ddribin/piano-lights-hw/README.md

# Piano Lights Hardware

Specialized hardware to displays lights (LEDs) over piano keys.

See a [demo video on YouTube](https://youtu.be/pe3vuLcroIA).
