ddribin/piano-lights-hw/faceplate/midi-out-faceplate.dxf

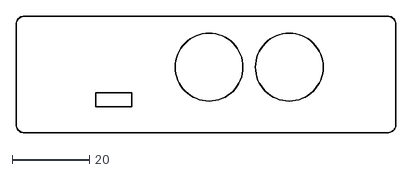
[picture p1: CAD file, 2023-07-03]
faceplate/midi-out-faceplate.dxf
98.0 x 30.0
