ddribin/piano-lights-hw/faceplate/midi-in-faceplate.dxf

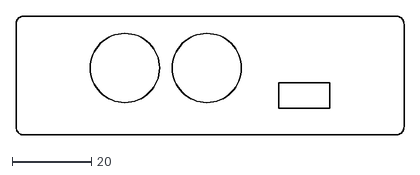
[picture p2: CAD file, 2023-07-03]
faceplate/midi-in-faceplate.dxf
98.0 x 30.0
