ddribin/piano-lights-hw/pcb/piano-lights.kicad_pcb

## KiCad design pcb/piano-lights.kicad_pcb (2023-08-04)

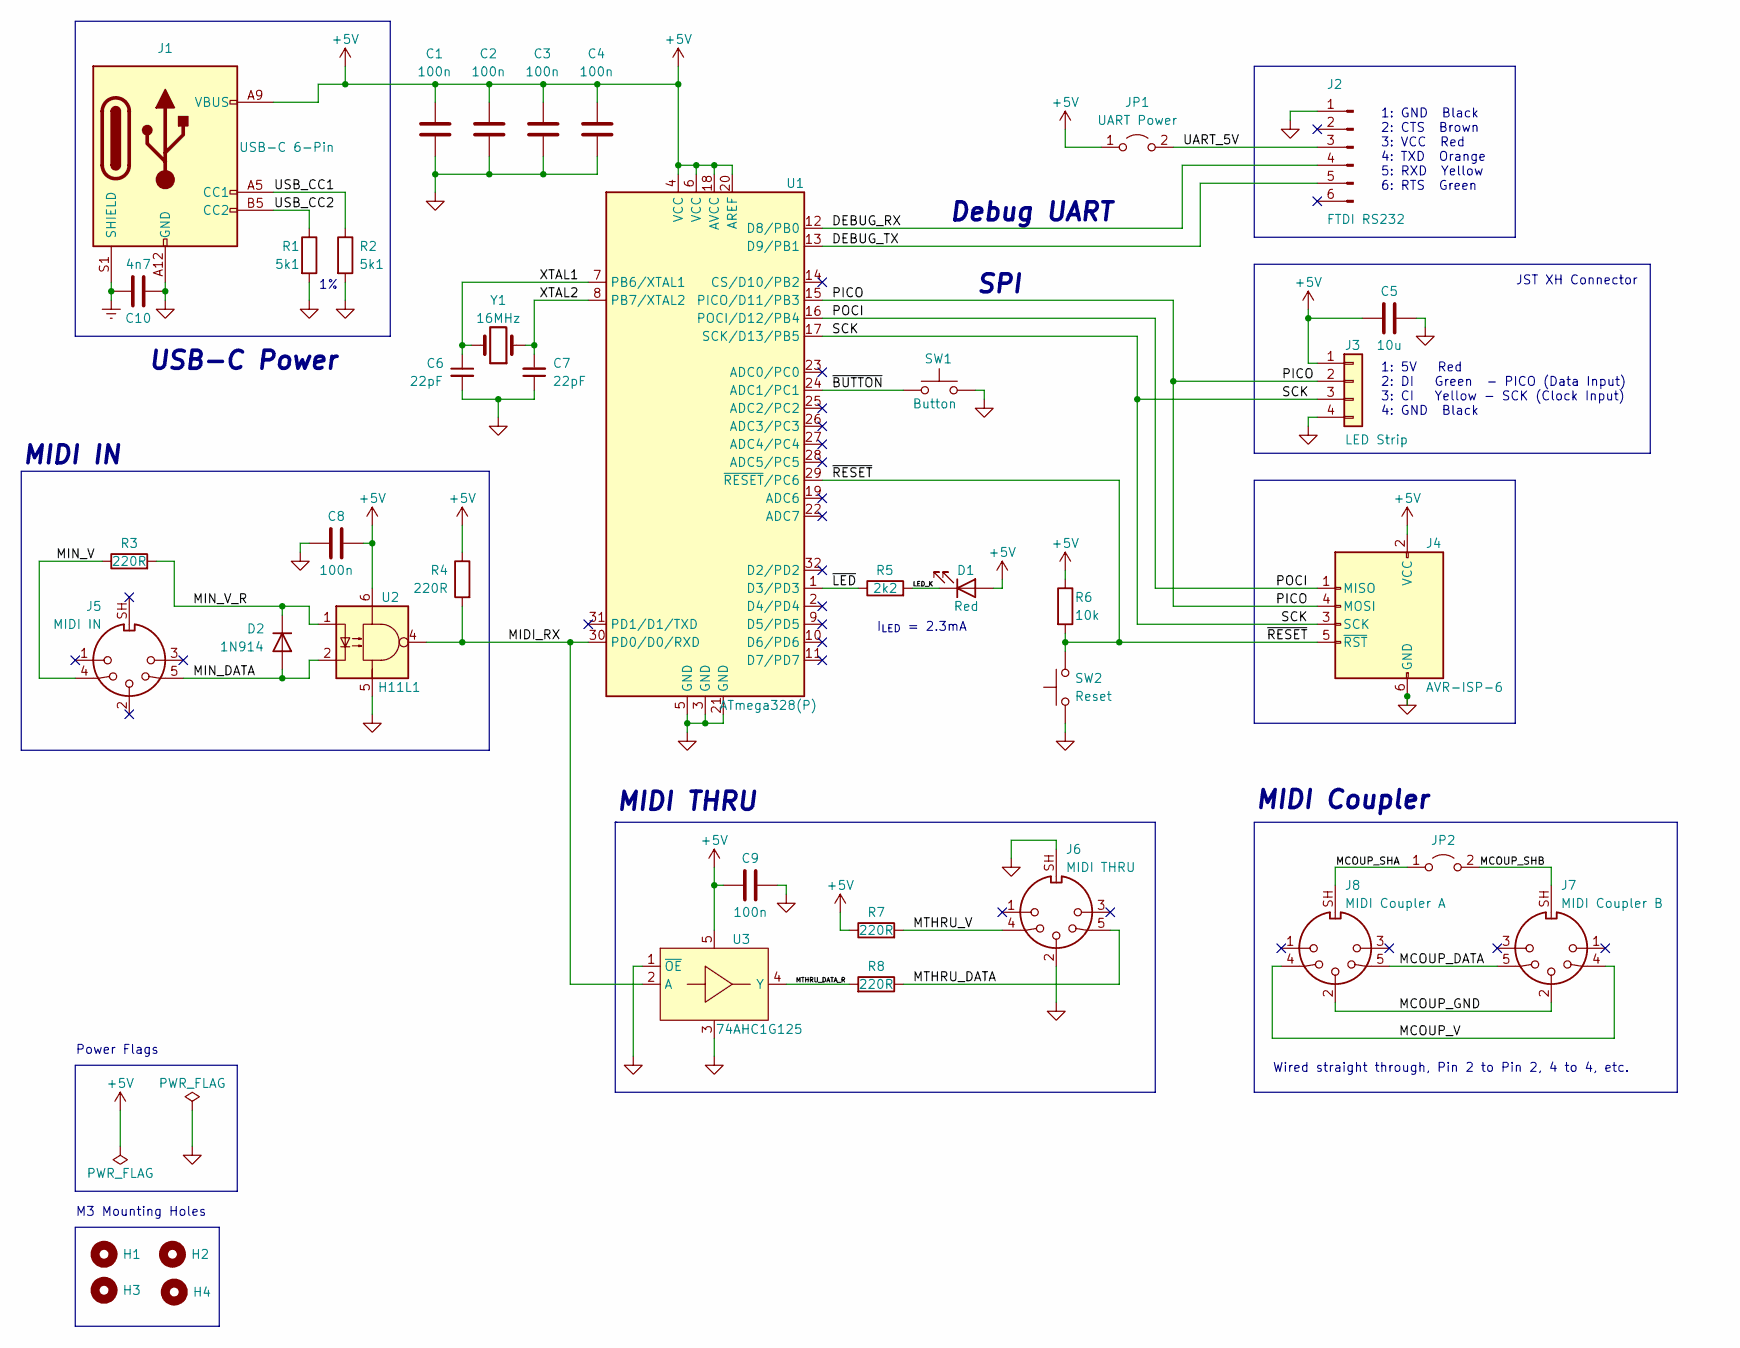
[picture p3: schematic piano-lights.kicad_sch, Piano Lights]

Parts:
C1, C2, C3, C4, C8, C9: 100n; C_0603_1608Metric_Pad1.08x0.95mm_HandSolder; Mfr Part GRM188R72A104KA35D
C5: 10u; CP_Radial_D5.0mm_P2.00mm; Mfr Part UVR1C100MDD
C6, C7: 22pF; C_0603_1608Metric_Pad1.08x0.95mm_HandSolder; Mfr Part GCM1885C2A220JA16D
C10: 4n7; C_0805_2012Metric_Pad1.18x1.45mm_HandSolder; Mfr Part GRM2165C1H472JA01D
D1: Red; LED_0603_1608Metric_Pad1.05x0.95mm_HandSolder; Mfr Part SML-D12U8WT86
D2: 1N914; D_SOD-123; Mfr Part MMSD4148T1G
H1, H2, H3, H4: MountingHole; MountingHole_3.2mm_M3
J1: USB-C 6-Pin; GCT_USB4125-GF-A-0190_REVA2; Mfr Part USB4125-GF-A-0190
J2: FTDI RS232; PinHeader_1x06_P2.54mm_Vertical
J3: LED Strip; JST_XH_S4B-XH-A_1x04_P2.50mm_Horizontal
J4: AVR-ISP-6; PinHeader_2x03_P2.54mm_Vertical; Mfr Part PR20203VBDN
J5: MIDI IN; CUI_SDS-50J; Mfr Part SDS-50J
J6: MIDI THRU; CUI_SDS-50J; Mfr Part SDS-50J
J7: MIDI Coupler B; CUI_SDS-50J; Mfr Part SDS-50J
J8: MIDI Coupler A; CUI_SDS-50J; Mfr Part SDS-50J
JP1: UART Power; PinHeader_1x02_P2.54mm_Vertical
JP2: MIDI Coupler Shield; PinHeader_1x02_P2.54mm_Vertical
R1, R2: 5k1; R_0603_1608Metric_Pad0.98x0.95mm_HandSolder; Mfr Part RC0603FR-075K1L
R3, R4, R7, R8: 220R; R_0603_1608Metric_Pad0.98x0.95mm_HandSolder; Mfr Part RC0603JR-07220RL
R5: 2k2; R_0603_1608Metric_Pad0.98x0.95mm_HandSolder; Mfr Part RC0603JR-072K2L
R6: 10k; R_0603_1608Metric_Pad0.98x0.95mm_HandSolder; Mfr Part RC0603JR-0710KL
SW1: Button; SW_PUSH_6mm_H5mm; Mfr Part CT11025.0F160
SW2: Reset; SW_PUSH_6mm_H5mm; Mfr Part CT11025.0F160
U1: ATmega328(P); TQFP-32_7x7mm_P0.8mm; Mfr Part ATMEGA328-AUR
U2: H11L1; SMDIP-6_W9.53mm; Mfr Part H11L1M
U3: 74AHC1G125; SOT-23-5_HandSoldering; Mfr Part 74AHC1G125GV,125
Y1: 16MHz; Crystal_HC49-U_Vertical; Mfr Part ECS-160-18-4X-CKM

Connections:
+5V: C1.1, C2.1, C3.1, C4.1, C5.1, C8.2, C9.1, D1.2 (A), J1.A9 (VBUS), J1.B9 (VBUS), J3.1, J4.2 (VCC), JP1.1 (A), R4.1, R6.1, R7.1, U1.4 (VCC), U1.6 (VCC), U1.18 (AVCC), U1.20 (AREF), U2.6, U3.5
/DEBUG_RX: J2.4, U1.12 (D8/PB0)
/DEBUG_TX: J2.5, U1.13 (D9/PB1)
/LED_K: D1.1 (K), R5.2
/MCOUP_DATA: J7.5, J8.5
/MCOUP_GND: J7.2, J8.2
/MCOUP_SHA: J8.SH, JP2.1 (A)
/MCOUP_SHB: J7.SH, JP2.2 (B)
/MCOUP_V: J7.4, J8.4
/MIDI_RX: R4.2, U1.30 (PD0/D0/RXD), U2.4, U3.2 (A)
/MIN_DATA: D2.2 (A), J5.5, U2.2
/MIN_V: J5.4, R3.1
/MIN_V_R: D2.1 (K), R3.2, U2.1
/MTHRU_DATA: J6.5, R8.1
/MTHRU_DATA_R: R8.2, U3.4 (Y)
/MTHRU_V: J6.4, R7.2
/PICO: J3.2, J4.4 (MOSI), U1.15 (PICO/D11/PB3)
/POCI: J4.1 (MISO), U1.16 (POCI/D12/PB4)
/SCK: J3.3, J4.3 (SCK), U1.17 (SCK/D13/PB5)
/UART_5V: J2.3, JP1.2 (B)
/USB_CC1: J1.A5 (CC1), R2.1
/USB_CC2: J1.B5 (CC2), R1.1
/XTAL1: C6.1, U1.7 (PB6/XTAL1), Y1.2
/XTAL2: C7.2, U1.8 (PB7/XTAL2), Y1.1
/~BUTTON: SW1.1, U1.24 (ADC1/PC1)
/~LED: R5.1, U1.1 (D3/PD3)
/~RESET: J4.5 (~RST), R6.2, SW2.2, U1.29 (~RESET/PC6)
Earth: C10.2, J1.S1 (SHIELD)
GND: C1.2, C2.2, C3.2, C4.2, C5.2, C6.2, C7.1, C8.1, C9.2, C10.1, J1.A12 (GND), J1.B12 (GND), J2.1, J3.4, J4.6 (GND), J6.2, J6.SH, R1.2, R2.2, SW1.2, SW2.1, U1.3 (GND), U1.5 (GND), U1.21 (GND), U2.5, U3.1 (~OE), U3.3

Notes on the sheet:
1: GND Black 2: CTS Brown 3: VCC Red 4: TXD Orange 5: RXD Yellow 6: RTS Green
MIDI THRU
Debug UART
1: 5V Red 2: DI Green - PICO (Data Input) 3: CI Yellow - SCK (Clock Input) 4: GND Black
Wired straight through, Pin 2 to Pin 2, 4 to 4, etc.
JST XH Connector
I_{LED} = 2.3mA
USB-C Power
MIDI IN
SPI
MIDI Coupler
Power Flags
M3 Mounting Holes

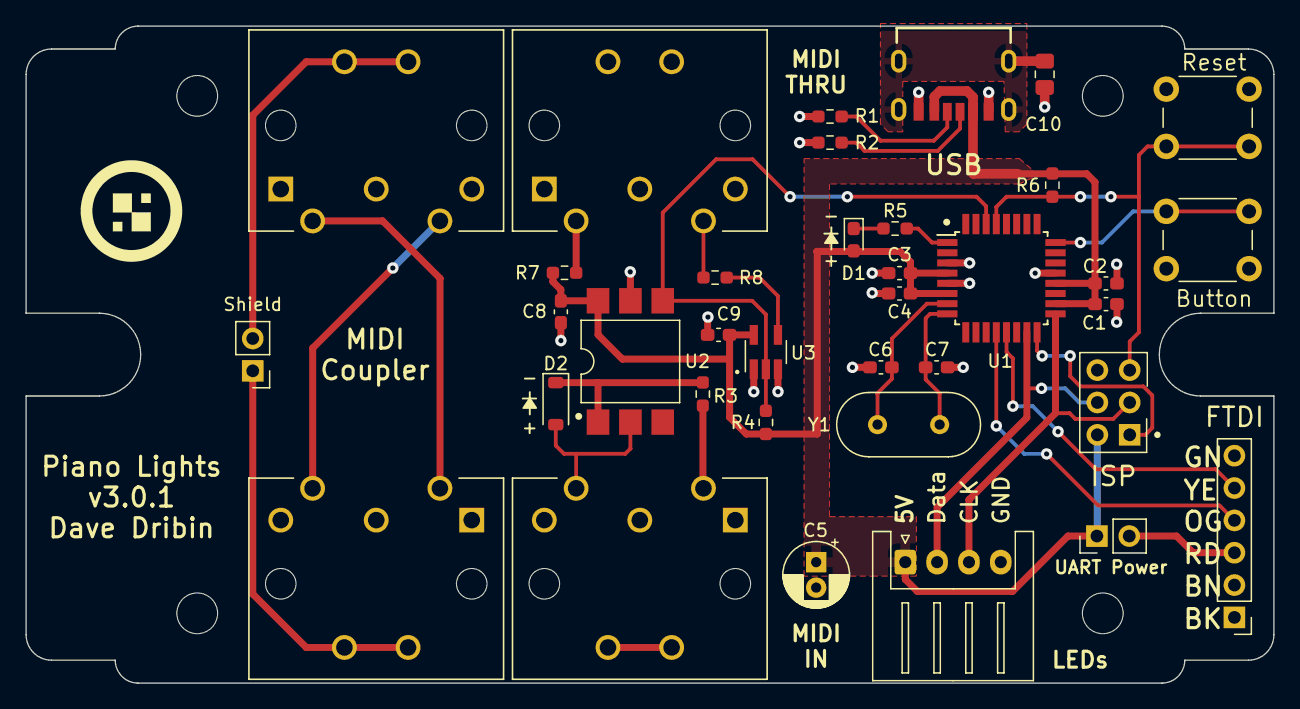
[picture p4: board piano-lights.kicad_pcb from above]

Board: 2 copper layers, 98.0 x 51.6 mm, 41 parts (0 on the bottom side), 29 nets.

Other parts of the board:
G1: LOGO
