ddribin/piano-lights-hw/(threads)

Thread 1 (2022-07-12):

Diode footprint is incorrect - should be MiniMELF not 0805

ddribin, 2022-07-12:
In `v1.0.0`, the footprint for Diode D2 (the reverse protection diode on MIDI IN) has a "0805" footprint when it should be "MiniMELF (SOD-80)" as that is much more common for SMD diodes.

ddribin, 2022-07-12:
Link to the Microchip 1N914UR at Digi-Key: https://www.digikey.com/en/products/detail/microchip-technology/1N914UR/4379567

ddribin, 2022-08-12:
Fixed in v1.0.1.

Closed 2022-08-12.

Thread 2 (2022-07-12):

Switch to SMD part for H11L1

ddribin, 2022-07-12:
The through-hole variant of the H11L1 optocoupler is mostly out of stock and hard to find. Switch to the surface mount part and footprint, as that is currently still readily available (as of July 2022, at least).

ddribin, 2022-07-16:
Opened against `v1.0.0`.

Closed 2023-03-06.

Thread 3 (2022-07-16):

Inputs to H11L1 optocoupler are reversed

ddribin, 2022-07-16:
The inputs to H11L1 optocoupler are reversed. `MIDI IN Data` is going into the anode and `MIDI IN Vcc` is going to cathode. This is incorrect. `Data` should go to the cathode and `Vcc` should go to the anode.

Incorrect schematic as of `v1.0.0`:

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

Correct schematic from the MIDI standard:

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

I think what threw me is the picture of internal diode for the H11L1 is reversed from the MIDI standard.

ddribin, 2022-08-12:
Fixed in v1.0.1.

Closed 2022-08-12.

Thread 4 (2022-07-16):

MIDI IN output from the optocoupler is missing a pull-up resistor

ddribin, 2022-07-16:
The MIDI IN output from the optocoupler is missing a pull-up resistor. Here's the schematic as of `v1.0.0`:

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

And here is the MID standard:

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

The pull-up resistor, `Rd` is missing.

ddribin, 2022-08-12:
Fixed in v1.0.1.

Closed 2022-08-12.

Thread 5 (2022-08-08):

No solder mask between USB connector pads

ddribin, 2022-08-08:
In `v1.0.0`, the solder mask constraints did not allow solder mask between the USB connector pads. See the attached screenshot. This made it difficult to solder the pads as it was hard to avoid solder bridges between the pads. This is not super critical, as none of the data pins are connected with a USB changer, but bridges should be avoided in case the data lines are actually connected.

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

ddribin, 2022-08-12:
This happened because the "Board Stickup > Solder Mask/Paste > Solder mask minimum web width" was set to 0.2mm, as seen in the screen shot. The the copper for the pads is 0.2mm apart, but the solder mask goes over by 0.05mm leaving a 0.1mm gap between the solder mask, which is below this "web width".  Setting it to 0.1mm or lower (e.g. 0.05mm) allows solder mask between between the pads.

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

ddribin, 2022-08-12:
Fixed in v1.0.1.

ddribin, 2022-08-12:
Fixed it looks like this:

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

Closed 2022-08-12.

Thread 10 (2023-03-06):

Change FTDI +5V trace to a normal power trace, instead of copper pour

ddribin, 2023-03-06:
Change FTDI power to a normal trace, instead of copper pour. The pour is unnecessary as FTDI cannot supply that much current, anyways. Even when using a serial port, it will most likely still be powered by the USB-C port.

Closed 2023-03-06.

Thread 7 (2023-03-06):

Switch LED to 0603 package

ddribin, 2023-03-06:
In `v2.0.0`, the LED is an `0805`. Switch to `0603`, maybe?

ddribin, 2023-03-06:
This does not save that much space, but possible replacement is Rohm SML-D12U8WT86: https://www.digikey.com/short/h5q7qdm2

ddribin, 2023-03-13:
Changed it for consistency.

Closed 2023-03-13.

Thread 8 (2023-03-06):

Switch LED strip to some sort of connector

ddribin, 2023-03-06:
Soldering the LED strip wires directly to the board is kind of a pain. Also, there's a pigtail hanging off, that's annoying. It would be really nice to use some soft of wire-to-board connector instead of wires directl.

ddribin, 2023-03-06:
The current connector is a JST-SM connector, which has no wire-to-board option. Here's a list of common JST connectors:

https://www.mattmillman.com/info/crimpconnectors/common-jst-connector-types/

The JST PH or XH look like good options. The PH only supports 2A with AWG 24-28 wire, while XH is 3A with AWG 22-28 wire. Both support right-angle through-hole headers. I am thinking XH is good, due to the bigger wires, but need to do some test crimps.

ddribin, 2023-03-06:
JST PH housing, 4 position is `PHR-4`: https://www.arrow.com/en/products/phr-4/jst-manufacturing
Contact AWG 24-30 is `SPH-002T-P0.5S`: https://www.arrow.com/en/products/sph-002t-p0.5s/jst-manufacturing

JST XH housing, 4 position is `XHP-4`: https://www.arrow.com/en/products/xhp-4/jst-manufacturing
Contact AWG 22-28 is `SXH-001T-P0.6`:  https://www.arrow.com/en/products/sxh-001t-p0.6/jst-manufacturing

ddribin, 2023-03-13:
`S4B-XH-A` looks like a good fit. While `S4B-XH-A-1` has a smaller profile, it doesn't help board layout, and in fact makes the power pour more difficult, so stick with `S4B-XH-A`.

Closed 2023-03-13.

Thread 9 (2023-03-06):

Switch to SMD push buttons

ddribin, 2023-03-06:
Switch to SMD push buttons instead of through hole.

ddribin, 2023-03-06:
Possible replacement: C&K PTS645SH43SMTR92 LFS: https://www.digikey.com/short/v84t9hpm

ddribin, 2023-03-06:
The SMD footprints are actually larger than the through-hole. Plus vias are still needed to ground Not sure how much benefit there is to this?

ddribin, 2023-03-06:
Footprint would be `SW_Push_1P1T_NO_6x6mm_H9.5mm`

ddribin, 2023-03-13:
These take up more room on the PCB making things harder to layout.

Thread 11 (2023-03-07):

Switch crystal to SMD

ddribin, 2023-03-07:
Switch the crystal to SMD. Current part is ECS `ECS-160-18-4X-CKM`, 16MHz 18pF load capacitance, through hole HC-49USX.

ddribin, 2023-03-07:
Alternative looks to be ECS `ECS-160-18-5PXEN-TR`: https://www.digikey.com/short/790zwv4t

ddribin, 2023-03-13:
This ends up taking more room on the PCB making things harder to layout.

Thread 12 (2023-07-01):

Isolate USB-C shield from ground

ddribin, 2023-07-01:
There doesn't seem to be a good consensus here, but the USB-C shield should maybe be isolated from signal ground.

Some references:

# Microchip: USB Type-C Layout Recommendations

Shield is connected to ground through an RC filter with unspecified R and C.

https://microchip.my.site.com/s/article/USB-Type-C-Layout-Recommendations

> There should be a wide Earth Ground flood around the USB Type-C connector that connects to the connector shield pins. Earth Ground should also be tied to Digital Ground through an R/C galvanic circuit that is placed as close as possible to the USB Type-C connector (see R20 and C2 in Figure 1).

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

# Atmel AVR1017: USB Hardware Design Recommendations

Shield is connected to ground through an RC filter with R=1M and C=4n7.

https://ww1.microchip.com/downloads/en/Appnotes/doc8388.pdf

> Tying the shield directly to ground would create a direct path from the ground plane to the shield, turning the USB cable into an antenna. To limit the USB cable antenna effect, it is recommended to connect the shield and ground through an RC filter. Typically, R = 1MΩ and C = 4.7nF in Figure 3-5.

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

# PCBWay: How to add USB-C to your projects

Shield is connected to ground through a 1M resistor.

https://www.pcbway.com/blog/PCB_Design_Tutorial/How_to_add_USB_C_to_your_projects.html

> However, compared to the micro USB-B two resistors are needed on pins CC1 and CC2. Then just add a 1M resistor to the connector shield. Also, you just connect the following lines (Vbus, D +, D-, GND) as you usually do with the micro USB-B. You can leave all other pins unconnected.

# Arduino Forums: Should I connect Micro USB B shield to the ground?

Shield is unconnected. Should only be connected on the computer end. Thus unconnected on a device.

https://forum.arduino.cc/t/should-i-connect-micro-usb-b-shield-to-the-ground/960018/3

# SparkFun: USB-C Breakout

Shield is unconnected.

https://www.sparkfun.com/products/15100
https://github.com/sparkfun/USB-C-Breakout
https://forum.digikey.com/t/simple-way-to-use-usb-type-c-to-get-5v-at-up-to-3a-15w/7016

# Adafruit: USB-C Breakpoint

Shield is unconnected.

https://www.adafruit.com/product/4090
https://github.com/adafruit/Adafruit-USB-C-Downstream-Breakout

# Phil's Lab: USB-C Power Delivery

Shield is unconnected.

https://youtu.be/W13HNsoHj7A?t=724

# Phil's Lab: USB Hub Design

Shield is connected to ground through 4n7F capacitor.

https://youtu.be/iR2hYpq0KI0?t=576

# Phil's Lab: USB Headphone Amplifier

Shield connected to ground through an RC filter with R=DNP and C=2n2F.

https://youtu.be/-L-fKuAbQ9s?t=527

# Dubious Creations: ESP32 LED Driver

Shield is connected directly to ground.

https://dubiouscreations.com/2021/05/04/designing-an-esp32-based-rgb-matrix-driver-and-making-500-of-them/
https://github.com/matthewlai/ESP32LEDControl
https://dubiouscreations.com/2021/04/06/designing-with-usb-c-lessons-learned/

ddribin, 2023-07-01:
In summary, all possible permutations are "recommended":

- Connect shield to ground through an RC filter, with R = 1M and C = 4.7nF.
- Connect shield to ground through only a 1M resistor.
- Connect shield to ground through only a 4n7F.
- Connect shield directly to ground.
- Leave shield unconnected.

My guess is that the RC filter is the most robust, but also is the most difficult to layout.

I think I'm going to take a middle road, and add a single 0803 connection from shield (Earth) to ground (GND). Then it can handle every case, except the RC filter:

- Leave it unpopulated.
- Use a 0R resistor.
- Use a 1M resistor
- Use a 4n7F capacitor.

Closed 2023-07-04.

Thread 13 (2023-07-28):

Silkscreen for LED D1 is reversed

ddribin, 2023-07-28:
The silkscreen for LED D1 is reversed on the PCB in `v3.0.0`:

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

The `+` sign should be on the `+5` wire.

Closed 2023-07-28.
