ddribin/piano-lights-hw/(commit log)

2022-06-04 Flesh out circuit
    [piano-lights.kicad_sch]
2022-06-04 Add debug port and more net labels
    [piano-lights.kicad_sch]
2022-06-08 Restructure the schematic and start adding footprints
    [piano-lights.kicad_sch]
2022-06-09 Finish footprints. Start laying out PCB.
    [piano-lights.kicad_pcb, piano-lights.kicad_sch]
2022-06-09 More PCB updates
    [piano-lights.kicad_pcb]
2022-06-10 Start the board layout
    [piano-lights.kicad_pcb, piano-lights.kicad_sch]
2022-06-18 PCB updates
    [piano-lights.kicad_pcb]
2022-06-19 Start re-working schematic (again)
    [piano-lights.kicad_sch]
2022-06-19 Finish reworking schematic
    [piano-lights.kicad_sch]
2022-06-19 Renumber components, and start over on the PCB.
    [piano-lights.kicad_pcb, piano-lights.kicad_sch]
2022-06-19 Update 74AHC1G125 symbol so that VCC and GND are at the top and bottom, respectively
    [piano-lights.kicad_sch]
2022-06-19 Minor schematic and PCB updates
    [piano-lights.kicad_pcb, piano-lights.kicad_sch]
2022-06-19 Move reset switch
    [piano-lights.kicad_sch]
2022-06-19 Move LED to D7/PD7
    [piano-lights.kicad_sch]
2022-06-19 Fix misaligned POCI wire
    [piano-lights.kicad_sch]
2022-06-19 Add in a switch on D2/PD2. Move MIDI_RX to the left side.
    [piano-lights.kicad_sch]
2022-06-19 Clean up MIDI IN and THRU. Rename shield pin on the DIN5 connector to match the conventions.
    [piano-lights.kicad_sch]
2022-06-20 Add some 3D models and start laying out PCB (it's too small, though)
    [piano-lights.kicad_pcb, piano-lights.kicad_sch]
2022-06-21 Start laying out PCB
    [piano-lights.kicad_pcb, piano-lights.kicad_sch]
2022-06-22 Tweeak dimensions. Move LED connector to other side, closer to USB power.
    [piano-lights.kicad_pcb]
2022-06-22 Fully route board. Does not pass DRC, yet.
    [piano-lights.kicad_pcb]
2022-06-22 Fix up copper pours power puddles on the front
    [piano-lights.kicad_pcb]
2022-06-22 PCB tweaks
    [piano-lights.kicad_pcb]
2022-06-25 Fix up silk screen. Fix all DRC errors. Tweak position of LED holes.
    [piano-lights.kicad_pcb]
2022-06-26 Add a cutout in the side.
    [piano-lights.kicad_pcb]
2022-06-26 Add some more silk screen info
    [piano-lights.kicad_pcb]
2022-06-26 Minor trace tweaks. Move origin to center.
    [piano-lights.kicad_pcb]
2022-06-26 Clean up somem more tracks and passive placement
    [piano-lights.kicad_pcb]
2022-06-26 Update version text and date.
    [piano-lights.kicad_pcb, piano-lights.kicad_sch]
2022-06-26 Add a jumper for 5V UART power. Add more silk.
    [piano-lights.kicad_pcb, piano-lights.kicad_sch]
2022-06-26 Final tweaks
    [piano-lights.kicad_pcb]
2022-06-27 Tweak silkscreen
    [piano-lights.kicad_pcb]
2022-06-27 Make the hole wider
    [piano-lights.kicad_pcb]
2022-06-30 Last minue DRC updates for JLCPCB
    [piano-lights.kicad_pcb, piano-lights.kicad_sch]
2022-06-30 Update solder mask DRC
    [piano-lights.kicad_pcb]
2022-07-17 Mock up fixes for reversed H11L1 inputs and pull-up
    [piano-lights.kicad_pcb, piano-lights.kicad_sch]
2022-07-18 Clean up schematic mainly around MIDI IN
    [piano-lights.kicad_pcb, piano-lights.kicad_sch]
2022-07-18 Switch MIDI IN diode footprint to MiniMELF
    - Add some more silkscreen around AVR ISP-6 header.
    - Add silscreen text for USB Power.
    [piano-lights.kicad_pcb, piano-lights.kicad_sch]
2022-07-18 Fix DRC issues
    [piano-lights.kicad_pcb]
2022-07-18 Minor reroutes around MIDI IN
    [piano-lights.kicad_pcb]
2022-07-22 Silkscreen updates
    [piano-lights.kicad_pcb]
2022-08-07 Minor re-routing
    [piano-lights.kicad_pcb]
2022-08-07 Add some test points
    [piano-lights.kicad_pcb, piano-lights.kicad_sch]
2022-08-07 Update plot settings for JLCPCB
    [piano-lights.kicad_pcb]
2022-08-08 Update solder mask constraints to allow solder mask between USB connector pads
    - Update some JLCPCB constraints.
    - Update front copper pours to be right angles.
    [piano-lights.kicad_pcb]
2022-08-08 Move gerbers/ ignore to pcb/.gitignore
2022-08-12 Put component values on silkscreen
    [piano-lights.kicad_pcb]
2022-08-12 More silkscreen updates
    [piano-lights.kicad_pcb, piano-lights.kicad_sch]
2022-08-12 Update dates
    [piano-lights.kicad_pcb, piano-lights.kicad_sch]
2023-02-09 First pass at smaller PCB with MIDI coupler
    [piano-lights.kicad_pcb, piano-lights.kicad_sch]
2023-02-09 Fix up schematic, update to SMD CPU, and start laying out board
    [piano-lights.kicad_pcb, piano-lights.kicad_sch]
2023-02-10 More PCB routing
    [piano-lights.kicad_pcb, piano-lights.kicad_sch]
2023-02-10 Finish first pass of routing: no more unrouted nets. It fits!
    [piano-lights.kicad_pcb]
2023-02-11 Cleanup MIDI coupler wiring a bit
    [piano-lights.kicad_pcb]
2023-02-11 More routing updates
    [piano-lights.kicad_pcb]
2023-02-13 Update track widths
    [piano-lights.kicad_pcb]
2023-02-13 Add the button back, but on a different pin. Start cleaning up silkscreen
    [piano-lights.kicad_pcb, piano-lights.kicad_sch]
2023-02-13 Finish cleaning up silkscreen. Passes DRC. Add dimensions.
    [piano-lights.kicad_pcb]
2023-02-13 Last silkscreen tweaks
    [piano-lights.kicad_pcb]
2023-02-13 Reroute /LED signal away from the crystal
    [piano-lights.kicad_pcb]
2023-02-13 Move /LED to Pin 1 for easier PCB routing
    [piano-lights.kicad_pcb, piano-lights.kicad_sch]
2023-02-13 Update silkscreen for LED strip
    [piano-lights.kicad_pcb]
2023-02-13 Add silkscreen for all RS323/FTDI pins
    [piano-lights.kicad_pcb]
2023-02-13 More siklscreen tweaks
    [piano-lights.kicad_pcb]
2023-02-13 Simplify power distribution a bit
    [piano-lights.kicad_pcb]
2023-02-16 Start adding mfr, part, and vendor to schematic
    [piano-lights.kicad_sch]
2023-02-16 Add more Mfr notes
    [piano-lights.kicad_sch]
2023-02-16 Add more Mfr comments. Switch to SMD 0805 LED
    [piano-lights.kicad_pcb, piano-lights.kicad_sch]
2023-02-16 Update footprint of USB connector
    [piano-lights.kicad_pcb]
2023-02-16 Add logo on PCB silkscreen
    [piano-lights.kicad_pcb]
2023-02-16 Update revision and date
    [piano-lights.kicad_pcb, piano-lights.kicad_sch]
2023-02-18 Add USB-C Power only connector footprint for GCT USB4125-GF-A-0190.
2023-02-18 Switch to USB-C 6-Pin for power on the schematic
    [piano-lights.kicad_sch]
2023-02-18 Start wiring up USB-C connector
    [piano-lights.kicad_pcb, piano-lights.kicad_sch]
2023-02-18 Route out +5V to the LEDs with a copper pour
    [piano-lights.kicad_pcb]
2023-02-18 Widden +5V copper pour to 2mm
    [piano-lights.kicad_pcb]
2023-02-18 Increase Power net class width to 0.55mm
    [piano-lights.kicad_pcb]
2023-02-18 Make via sizes larger at 0.4mm drill and 0.9mm diameter. Fix resulting DRC errors.
    [piano-lights.kicad_pcb]
2023-02-18 Make longer pads on USB-C connector
    [piano-lights.kicad_pcb]
2023-02-18 Remove some extra silkscreen
    [piano-lights.kicad_pcb]
2023-02-18 Tweak hole clearances
    [piano-lights.kicad_pcb]
2023-02-18 Fix DRC errors and pull back the soldermask expansion to 0.0508
    [piano-lights.kicad_pcb]
2023-02-18 Move USB-C connector over to the left a bit to make room for a resistor on the right
    [piano-lights.kicad_pcb]
2023-02-18 Make FTDI power trace thicker (1.6mm)
    [piano-lights.kicad_pcb]
2023-02-18 Align some schematic components to 0.050in grid
    [piano-lights.kicad_sch]
2023-02-18 Minre schematic tweaks
    [piano-lights.kicad_sch]
2023-02-18 Swap J1 and J2 designators so J1 is at the upper left
    [piano-lights.kicad_pcb, piano-lights.kicad_sch]
2023-02-18 Minor PCB tweaks
    [piano-lights.kicad_pcb]
2023-02-18 Use copper pour instead of thick traces, to get thermal reliefs around through holes
    [piano-lights.kicad_pcb]
2023-02-19 Set Mfr, Mfr Part, and Vendor on most other components
    [piano-lights.kicad_sch]
2023-02-19 Clean up MIDI coupler schematic a bit
    [piano-lights.kicad_sch]
2023-02-19 Clean up ERC and DRC issues
    [piano-lights.kicad_pcb, piano-lights.kicad_sch]
2023-02-19 Simplify MIDI coupler by mirroring the second connector horizontally
    [piano-lights.kicad_sch]
2023-02-19 More schematic cleanups
    [piano-lights.kicad_sch]
2023-02-19 Move R8 a bit away from the copper pour
    [piano-lights.kicad_pcb]
2023-02-19 Move U3 a bit away from the copper pour
    [piano-lights.kicad_pcb]
2023-02-19 Make LED data and clock thicker traces
    [piano-lights.kicad_pcb]
2023-02-19 Increase padding around KiBuzzard labels to 5mm
    [piano-lights.kicad_pcb]
2023-02-19 Tigthen up ground pour around board outline
    [piano-lights.kicad_pcb]
2023-02-19 Cleanup SCK track a bit
    [piano-lights.kicad_pcb]
2023-02-19 Fill in part data for crystal
    [piano-lights.kicad_sch]
2023-02-19 Rearrange R7 and C8
    [piano-lights.kicad_pcb]
2023-02-19 Move C9 closer to U3. Fix DRC errors.
    [piano-lights.kicad_pcb]
2023-02-20 Minor tweaks
    [piano-lights.kicad_pcb, piano-lights.kicad_sch]
2023-02-20 Fill out Mfr fields for last capacitor in the schematic
    [piano-lights.kicad_sch]
2023-02-21 Add a jumper on the coupler shield
    [piano-lights.kicad_pcb, piano-lights.kicad_sch]
2023-02-21 Bump clearance to 0.2mm (from 0.19mm)
    [piano-lights.kicad_pcb]
2023-02-21 Add a dot to H11L1 and slightly adjust the Button trace
    [piano-lights.kicad_pcb]
2023-02-21 Make button signl active low
    [piano-lights.kicad_pcb, piano-lights.kicad_sch]
2023-02-22 Add more dimensions in PCB to ensure they match the enclosure
    [piano-lights.kicad_pcb]
2023-02-22 Futz around with outline on the User.2 layer
    [piano-lights.kicad_pcb]
2023-02-22 In schematic, rename 'Button' signal to 'BUTTON' to be consistent with other signals
    [piano-lights.kicad_sch]
2023-02-22 Update copper pour clearance and minimum width to 0.3mm
    [piano-lights.kicad_pcb]
2023-02-23 Tweak copper pours again. Make sure all of them are consistent
    [piano-lights.kicad_pcb]
2023-02-23 Update changelog and dates on the sheets
    [piano-lights.kicad_pcb, piano-lights.kicad_sch]
2023-02-23 Increase +5V power plan thermal relief spokes to 0.76mm
    [piano-lights.kicad_pcb]
2023-02-23 Update output directories when plotting
    [piano-lights.kicad_pcb]
2023-02-23 Add an "R" suffix to the 220 ohm resistors
    [piano-lights.kicad_sch]
2023-03-06 Switch to SOD-123 package for diode #6
    [piano-lights.kicad_pcb, piano-lights.kicad_sch]
2023-03-06 Switch to SMD part of H11L1 #2
    [piano-lights.kicad_pcb, piano-lights.kicad_sch]
2023-03-06 Minor layout tweaks
    [piano-lights.kicad_pcb]
2023-03-06 Switch to SMD pushbutton switches #9
    [piano-lights.kicad_pcb, piano-lights.kicad_sch]
2023-03-06 Revert "Switch to SMD pushbutton switches #9"
    This reverts commit b74edbcdb394744f791cc2b63e3a5d736e74cc88.
    [piano-lights.kicad_pcb, piano-lights.kicad_sch]
2023-03-06 Fix up left ground plane that got moved
    [piano-lights.kicad_pcb]
2023-03-06 Move GND via of H11L1 underneath the chip
    [piano-lights.kicad_pcb]
2023-03-06 Change FTDI +5V trace to a normal power trace, instead of copper pour #10
    [piano-lights.kicad_pcb]
2023-03-06 Switch LED strip to JST XH right angle connector #8
    [piano-lights.kicad_pcb, piano-lights.kicad_sch]
2023-03-09 First attempt at MIDI IN faceplate
    [faceplate.scad, midi_in_faceplate.dxf, midi_in_faceplate.kicad_pcb, midi_in_faceplate.kicad_sch, midi_in_faceplate.scad]
2023-03-12 Tweak MIDI ports to match PCB
    [faceplate.scad, midi_in_faceplate.dxf, midi_in_faceplate.kicad_pcb, midi_in_faceplate.scad]
2023-03-12 Add a faceplate for the MIDI OUT side
    [faceplate.scad, midi_in_faceplate.kicad_pcb, midi_in_faceplate.scad, midi_out_faceplate.dxf, midi_out_faceplate.kicad_pcb, midi_out_faceplate.kicad_sch, midi_out_faceplate.scad]
2023-03-13 Update MIDI IN faceplate a bit
    [faceplate.scad, midi_in_faceplate.dxf, midi_in_faceplate.kicad_pcb, midi_in_faceplate.scad, midi_out_faceplate.kicad_pcb]
2023-03-13 Upgrade PCB to KiCad v7 file format
    [piano-lights.kicad_pcb]
2023-03-13 Tweak positions of MIDI connectors to be exactly aligned
    [piano-lights.kicad_pcb]
2023-03-13 Replace KiBuzzard text with new KiCad 7 custom font text
    [piano-lights.kicad_pcb]
2023-03-13 Upgrade schematic file format to KiCad v7
    [piano-lights.kicad_sch]
2023-03-13 Use a real monospace font (Menlo) for parts of schematic
    [piano-lights.kicad_sch]
2023-03-13 Fix new ERC errors (mostly grid issues, with some symbol updates)
    [piano-lights.kicad_sch]
2023-03-13 Switch to 0603 package for LED #7
    [piano-lights.kicad_pcb, piano-lights.kicad_sch]
2023-03-13 Fix up diode footprint
    [piano-lights.kicad_pcb, piano-lights.kicad_sch]
2023-03-14 Update MIDI diameter to 17.5mm
    [faceplate.scad, midi_in_faceplate.dxf, midi_in_faceplate.kicad_pcb, midi_out_faceplate.dxf, midi_out_faceplate.kicad_pcb]
2023-03-16 Fill in metadata and put version number (v2.1.0b1) on the back silkscreen
    [midi_in_faceplate.kicad_pcb, midi_out_faceplate.kicad_pcb]
2023-03-16 Rename faceplate files to use dashes instead of underscores
    [midi-in-faceplate.dxf, midi-in-faceplate.kicad_pcb, midi-in-faceplate.kicad_sch, midi-in-faceplate.scad, midi-out-faceplate.dxf, midi-out-faceplate.kicad_pcb, midi-out-faceplate.kicad_sch, midi-out-faceplate.scad]
2023-03-16 More file renaming
    [midi-in-faceplate.kicad_pcb, midi-out-faceplate.kicad_pcb]
2023-03-16 Add dimensions
    [midi-in-faceplate.kicad_pcb, midi-out-faceplate.kicad_pcb]
2023-06-11 Expand board out 1.8mm on the top and bottom
    [piano-lights.kicad_pcb]
2023-06-11 Better align one of the +5V copper pours
    [piano-lights.kicad_pcb]
2023-06-20 Tie USB-C shield to earth and add a 4n7F cap between earth and ground
    [piano-lights.kicad_pcb, piano-lights.kicad_sch]
2023-06-21 Reroute CC1 and CC2 to not cross ground split planes. Move Earth to front ground pour.
    [piano-lights.kicad_pcb]
2023-06-27 Rarrange CC1 and CC2 resistors to be next to each other
    [piano-lights.kicad_pcb]
2023-06-27 Silkscreen tweaks
    [piano-lights.kicad_pcb]
2023-06-27 Move C5 down a bit, so it aligns with the connector
    [piano-lights.kicad_pcb]
2023-06-27 Move R1 and R2 again
    [piano-lights.kicad_pcb]
2023-06-27 Rotate C1 and C2
    [piano-lights.kicad_pcb]
2023-06-27 Reroute +5V to C1 and C2
    [piano-lights.kicad_pcb]
2023-06-27 Update faceplates by moving all the holes up 1.6mm
    [faceplate.scad, midi-in-faceplate.dxf, midi-in-faceplate.kicad_pcb, midi-out-faceplate.dxf, midi-out-faceplate.kicad_pcb]
2023-06-27 Tweak Reset trace
    [piano-lights.kicad_pcb]
2023-06-27 Update CHANGELOG.md
    Minor PCB tweaks
    [piano-lights.kicad_pcb]
2023-06-29 Switch Earth to GND capacitor to 0803 (from 0603)
    [piano-lights.kicad_pcb, piano-lights.kicad_sch]
2023-07-03 Update offset around JST connector to 0.2mm (from 0.1mm)
    Update version numbers to 3.0.0
    [midi-in-faceplate.dxf, midi-in-faceplate.kicad_pcb, midi-in-faceplate.scad, midi-out-faceplate.kicad_pcb]
2023-07-03 Update faceplates
    [midi-in-faceplate.kicad_pcb, midi-in-faceplate.scad, midi-out-faceplate.dxf, midi-out-faceplate.kicad_pcb, midi-out-faceplate.scad]
2023-07-04 Update all versions to 3.0.0 and update date
    [midi-in-faceplate.kicad_pcb, midi-out-faceplate.kicad_pcb, piano-lights.kicad_pcb, piano-lights.kicad_sch]
2023-07-05 Update CHANGELOG and update release date
    [midi-in-faceplate.kicad_pcb, midi-out-faceplate.kicad_pcb, piano-lights.kicad_pcb, piano-lights.kicad_sch]
2023-07-05 Update PCB from schematic
    [piano-lights.kicad_pcb]
2023-07-28 Fix reversed silkscreen on LED D1 #13
    [piano-lights.kicad_pcb]
2023-07-28 Add text about JST XH connector on schematic
    [piano-lights.kicad_sch]
2023-08-04 Update verion and date for 3.0.1
    [piano-lights.kicad_pcb, piano-lights.kicad_sch]
2023-08-04 Zone refile for gerbers
    [piano-lights.kicad_pcb]
2023-08-04 Fix DRC warning on the graphic, by ignoring it
    [piano-lights.kicad_pcb]
2023-08-04 Fix SPICE ERC error by ignoring it
    [piano-lights.kicad_sch]
2023-12-01 .gitignore: Add KiCad lock files
2024-11-21 Add a comment about the 0.2mm offset
    [midi-out-faceplate.scad]
